jones139/GreenhouseController/greenhouseServer/www/tomato_200x200px.jpg

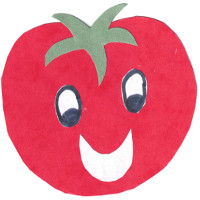
greenhouseServer/www/tomato_200x200px.jpg
