jones139/GreenhouseController/Hardware/raspberryPi3B/raspberryPi3BSimplified_STEP.STEP

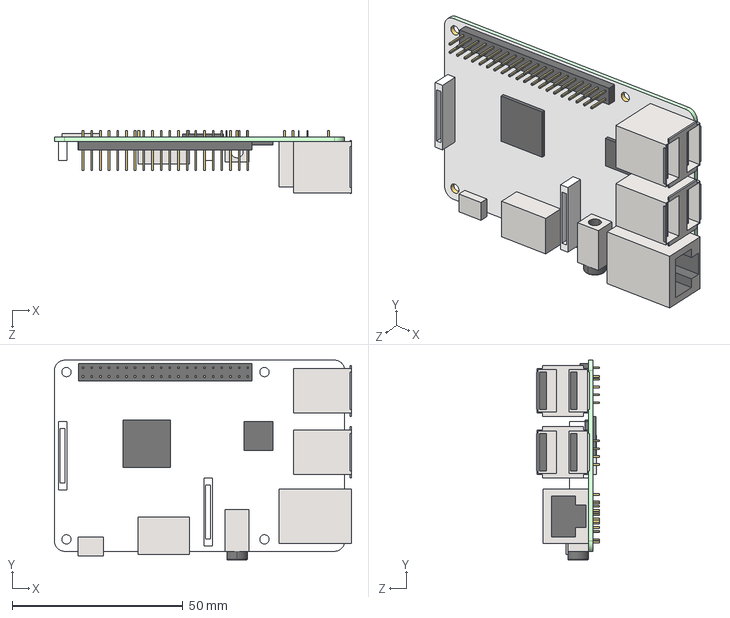
[picture p2: CAD file, 2023-04-12]
Hardware/raspberryPi3B/raspberryPi3BSimplified_STEP.STEP
87.0 x 58.5 x 18.6 mm
