jones139/GreenhouseController/Calibration.xlsx

Greenhouse Controller Calibration 15/06/2022
2.5 cycles of 60on/60off took 5:28 rather than 5:00 – clock frequency incorrect.
3 min (at actual clock frequency, not corrected) gave the following volumes dispensed – counting nozzles clockwise from left hand side near door.
1 | 220
2 | 225
3 | 220
4 | 225
5 | nc
6 | nc
7 | nc
8 | nc
9 | 215
10 | 220
Total Volume | 1325 | ml
Duration | 3 | min
So dispensing | 441.6666667 | ml/min
 | 0.442 | l/min
 | 0.074 | l/min/nozzle
Installed | 10.000 | Nozzles (2 each in 4 left hand growbags and 1 each in 2 right hand)
So Disensing | 0.736 | l/min
Sandie is using 2x 5l watering cans per day
Requirement | 10 | l/day
Time Req | 13.6 | min/day
Time Req | 0.566 | min/hr
Time Req | 33.96226415 | sec/hr
