jones139/GreenhouseController/greenhouseServer/sbsSvr.py

#!/usr/bin/env python
import os
import json
import argparse
import logging
import logging.handlers
import bottle
import WebControlClass
import sbsCfg
import sbsCtrl

class SbsSvr(WebControlClass.WebControlClass):
    mCtrl = None
    statusObj = {
        'lampOnOff' : 'Off',
        'kMirrorOnOff' : 'Off',
        }

    def __init__(self, configFname="sbscfg.json"):
        print("SbsSvr.__init__(%s)" % configFname)
        self.cfg = sbsCfg.loadConfig(configFname)

        # Create Log file output folder
        if not os.path.exists(self.cfg['logFolder']):
            os.makedirs(self.cfg['logFolder'])
        
        # Create Logger in folder specified in config file.
        self.logger = logging.getLogger(self.cfg['logName'])
        self.logger.setLevel(logging.DEBUG)
        fh = logging.handlers.TimedRotatingFileHandler(os.path.join(
            self.cfg['logFolder'], 
            "%s.log" % self.cfg['logName']),
            when='d', interval=1)
        fh.setLevel(logging.DEBUG)
        formatter = logging.Formatter('%(asctime)s - %(levelname)s - %(module)s.%(funcName)s[%(lineno)s] - %(message)s')
        fh.setFormatter(formatter)
        self.logger.addHandler(fh)
        self.logger.info("Initialising SBS Server")


        credFname = os.path.join(os.path.dirname(os.path.realpath(__file__)),"credentials.json")
        print("Loading Credentials from credFname=%s"% credFname)
        credStr = open(credFname,"r").read()
        self.mCred = json.loads(credStr.encode('utf-8'))
        print(self.mCred)
        self.mCtrl = sbsCtrl.SbsCtrl(configFname)
        super().__init__('0.0.0.0',8080)
        self.logger.info("Web Server Started")


    def stop(self):
        print("sbsSvr.stop()")
        self.logger.info("sbsSr.stop()")
        self.mCtrl.stop()
        #self.wwwThread.stop()
        

    def is_authenticated(user, password):
        for idObj in self.mCred:
            if (idObj['uname'].equals(user) and idObj['passwd'].equals(password)):
                return True
        return False
        
    def onWwwCmd(self,cmdStr,valStr, methodStr,request):
        ''' Process the command, with parameter 'valStr' using request
        method methodStr, and return the appropriate response.
        request is the bottlepy request associated with the command
        '''
        if (request.auth is None):
            print("Authentication Data not Provided")
            #return bottle.Response("Provide Credentials",401,{'WWW-Authenticate':'Basic realm="User"'})
            #return bottle.HTTPResponse(status=401, body="Authentication Data not PRovided")
            #bottle.abort(401,"Access Denied")
        #if (not self.is_authenticated(request.auth[0],request.auth[1])):
        #    print("NOT AUTHENTICATED")
            #return bottle.Response("403Unauthorised",403,{'WWW-Authenticate':'Basic realm="User"'})

        print("onWwwCmd: cmdStr=%s, valStr=%s, methodStr=%s" % (cmdStr,valStr,methodStr))
        retVal = "onWwwCmd - ERROR, command not recognised"
        if (cmdStr=="status"):
            retVal=self.getStatus()
        if (cmdStr=="config"):
            retVal=self.getConfig()
        if (cmdStr=="rebootSbs"):
            retVal=self.rebootSbs()
        if (cmdStr=="lampOnOff"):
            retVal=self.lampOnOff()
        if (cmdStr=="lampOn"):
            retVal = self.mCtrl.setLamp(True)
        if (cmdStr=="lampOff"):
            retVal = self.mCtrl.setLamp(False)
        if (cmdStr=="kMirrorStatus"):
            print("kMirrorStatus")
            #retVal=self.mCtrl.km.getStatus()
            retVal="k-mirror not implemented"
        if (cmdStr=="kMirrorSettings"):
            print("kMirrorSettings")
            #retVal=self.mCtrl.km.getSettings()
            retVal="k-mirror not implemented"
        if (cmdStr=="kMirrorHome"):
            print("kMirrorHome")
            #retVal=self.mCtrl.km.home()
            retVal="k-mirror not implemented"
        if (cmdStr=="kMirrorStart"):
            print("kMirrorStart")
            #retVal=self.mCtrl.km.start()
            retVal="k-mirror not implemented"
        if (cmdStr=="kMirrorStop"):
            print("kMirrorStop")
            #retVal=self.mCtrl.km.stop()
            retVal="k-mirror not implemented"
        if (cmdStr=="kMirrorMoveTo"):
            print("kMirrorMoveTo - %s." % valStr)
            #retVal=self.mCtrl.km.moveTo(int(valStr))
            retVal="k-mirror not implemented"
        if (cmdStr=="kMirrorSetCMin"):
            #retVal=self.mCtrl.km.setCMin(int(valStr))
            retVal="k-mirror not implemented"
        if (cmdStr=="kMirrorSetCMax"):
            #retVal=self.mCtrl.km.setCMax(int(valStr))
            retVal="k-mirror not implemented"
        if (cmdStr=="kMirrorSetSpeed"):
            #retVal=self.mCtrl.km.setSpeed(int(valStr))
            retVal="k-mirror not implemented"
        if (cmdStr=="kMirrorSetAcc"):
            #retVal=self.mCtrl.km.setAcc(int(valStr))
            retVal="k-mirror not implemented"
        if (cmdStr=="setGain"):
            retVal=self.mCtrl.setGain(int(valStr))
        print("SbsSvr.onWwwCmd(%s/%s %s): returning %s" % (cmdStr,valStr,methodStr,retVal))
        return(retVal)

    def getStatus(self):
        statusObj = self.mCtrl.getStatus()
        #kmStatusObj = self.mCtrl.km.getStatus()
        #if kmStatusObj is not None:
        #    statusObj['kMirror'] = {
        #        'running': int(kmStatusObj['running']),
        #        'curpos': int(kmStatusObj['curpos'])
        #    }
        #else:
        #    statusObj['kMirror'] = {
        #        'running': -1,
        #        'curpos': -1
        #    }
            
        return json.dumps(statusObj)

    def getConfig(self):
        return json.dumps(self.mCtrl.getConfig())

    def rebootSbs(self):
        retVal = os.system("sudo reboot")
        return retVal
    
    
    def lampOnOff(self):
        if (self.mCtrl.getStatus()['lampOn'] == False):
            self.mCtrl.setLamp(True)
        else:
            self.mCtrl.setLamp(False)
        return(self.mCtrl.getStatus())



    
    #def kMirrorOnOff(self):
    #    if (self.statusObj['kMirrorOnOff'] == "Off"):
    #        # FIXME really mirror motor on
    #        self.statusObj['kMirrorOnOff'] = 'On'
    #    else:
    #        # FIXME really turn mirror motor on
    #        self.statusObj['kMirrorOnOff'] = 'Off'
    #    return(self.statusObj)

    
if (__name__ == "__main__"):
    print("sbsSvr.__main__()")

    parser = argparse.ArgumentParser(description='SBS Control Server')
    parser.add_argument('--config', default="sbscfg.json",
                        help='Configuration file name')
    #parser.add_argument('-n', '--nContours',
    #                    default=10,
    #                    help='Number of Contours')
    #parser.add_argument('-t', '--title',
    #                    default="Beam Profile",
    #                    help='Plot Title')
    parser.add_argument('--debug', '-d', default=False,
                        action='store_true', dest='debug',
                        help='Run in debug mode')

    args = parser.parse_args()
    args = vars(args)
    print(args)

    configFname = args['config']

    svr = SbsSvr(configFname)
    svr.startServer()


    try:
        while svr.wwwThread.is_alive():
            svr.wwwThread.join(5)
    finally:
        svr.stop()
