jones139/GreenhouseController/(commit log)

2022-05-02 Initial commit - displays web page showing temp, humidity and light level and pulses solenoid to prove we can control water.
2022-05-05 Changed temperature/humitidy to SHT31 which uses the same I2C bus as the light sensor - because the DHT sensor crashed when the camera was accessed.
2022-06-11 Added code for dedicated Arduino based WaterController to do switching of water, with serial interface to change its parameters.
2022-06-15 Fixed issue with integer overruns so that we can have long delays - school boy error!
    [Calibration.xlsx]
2022-06-18 Started ESP8266 version of water controller so we can have an all-3.3V system by using a wemos D1 mini board instead of avr based microcontroller
2022-06-18 we now have access to files on the device - just need to actually do something with it now
2022-06-18 I think the ESP8266 waterController is working now - may be a bit of tidying up of serial output to do still
    [partitions.csv]
2022-06-20 Compilable version of main controller using temp/humidity sensor, light sensor and OLED display.
2022-06-22 Working on raspberry pi based data logger based on SBS controller
2022-06-26 Added second temperature sensor (DS18B20) on 1 wire bus
2022-06-26 Added second temperature sensor which we can put in the shade for better temperature readings
2022-06-30 Added water on/off timer (waterCtrl.py) - does not actually do anything yet though!
2022-06-30 GPIO control of water and monitoring of water state working - need to test with solenoid on the end to make sure we don't have noise issues.
    [flowDaemon.py, greenhouseCtrl.py, waterCtrl.py]
2022-07-02 Added logging of watering status and soil moisture probe digital output level.
2022-07-09 Changed soil monitor to use analogue output measured via i2c ADC.
2022-07-15 Added PID control based on measured soil resistance - drives to soil conductivity in micro-conductivity units (1e6/<resistance_units>)
2022-07-15 Re-hash of directory structure to get rid of old-versions to save confusion
    [Calibration.xlsx, partitions.csv]
2022-07-17 Added ability to modify setpoint and PID parameters from web interface. Removed re-sampling of graphs which sorted out X axis scrambling problem. Stored pid parameters in database so they refresh cor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
    [WebControlClass.py, dbConn.py, graphs.py, greenhouseCtrl.py, greenhouseSvr.py, waterCtrl.py]
2022-07-17 Fixed problem with water controller crashing (database not re-opened)
    [graphs.py, waterCtrl.py]
2022-07-23 Converted to use four capacitance type moisture sensors. Note hard wired offset for a 'dry' sensor - this should really be in the config file!
2022-07-24 Added logging to database for flowDaemon to monitor the actual on/off status of the water
2022-07-28 Started to add support for serial (Arduino) based soil moisture interface to replace ads1115 adc.
    [graphs.py, monitorDaemon.py, soilSerial.py, waterCtrl.py]
2022-07-28 Corrected issue with saving configuration to database - operating mode and onSecs were not being saved and restored correctly
    [dbConn.py, waterCtrl.py]
2022-07-28 Switched to storing %moisture rather than counts, with calibration stored in configuration file.
2023-04-12 Updated for new capacitive moisture sensors (3.3V regulated) with Firmata firmware on Arduino to measure them.
2023-04-12 Added soil sensor calibration description
    [Schematic.kicad_pcb, Schematic.kicad_sch, raspberryPi3BSimplified_STEP.STEP]
2023-04-14 Fixed problem with data logging crashing because I had a dict index incorrectly specified.
    [monitorDaemon.py, soilSerial.py]
2023-04-14 Updated wiring schedule for as-built V2 enclosure
2023-04-18 Updated soil sensor calibration write-up
    [Schematic.kicad_sch]
2023-05-18 Partially reinstated measurement using on-board ADC - currently measuring both ADC and Arduino and writing to log. Updated wiring for current V2 configuration.
2023-05-20 Switched back to on-board ADC rather than separate microcontroller. Renamed default configuration file to greenhouseCfg.json so it is more meaningful.
2023-05-20 Started dosing control daemon - does not seem to work yet, but might be a hardware issue...
    [dosingCtrl.py]
2023-05-24 Added monitoring of external ambient temperature sensor (temp3)
2023-05-24 Added simple logger that uses an arduino using the Firmata firmware to record four analogue readings of soil moisture level.
2023-05-24 Added external ambient temperature logging (temp3)
2023-05-29 Added notes on calibration of irrigation system
    [Calibration.xlsx]
2023-05-29 Sorted out problem with manual watering time not being saved in the DB, and incorrect figures displayed in the auto watering part of the user interface (problem was that the code was assuming the out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
    [greenhouseSvr.py, waterCtrl.py]
2023-06-23 Updated soil moisture sensor story...
